Kaioguilherme1/Estacao_Meteorologica_De_baixo_custo_Arduino/README.md

# Estacao_Meteorologica_De_baixo_custo_Arduino
 Trabalho de conclusão do curso Técnico em Agropecuária da Escola Agrotécnica da Universidade Federal de Roraima
