Kaioguilherme1/Estacao_Meteorologica_De_baixo_custo_Arduino/Documentos/Dados Coletados.pdf

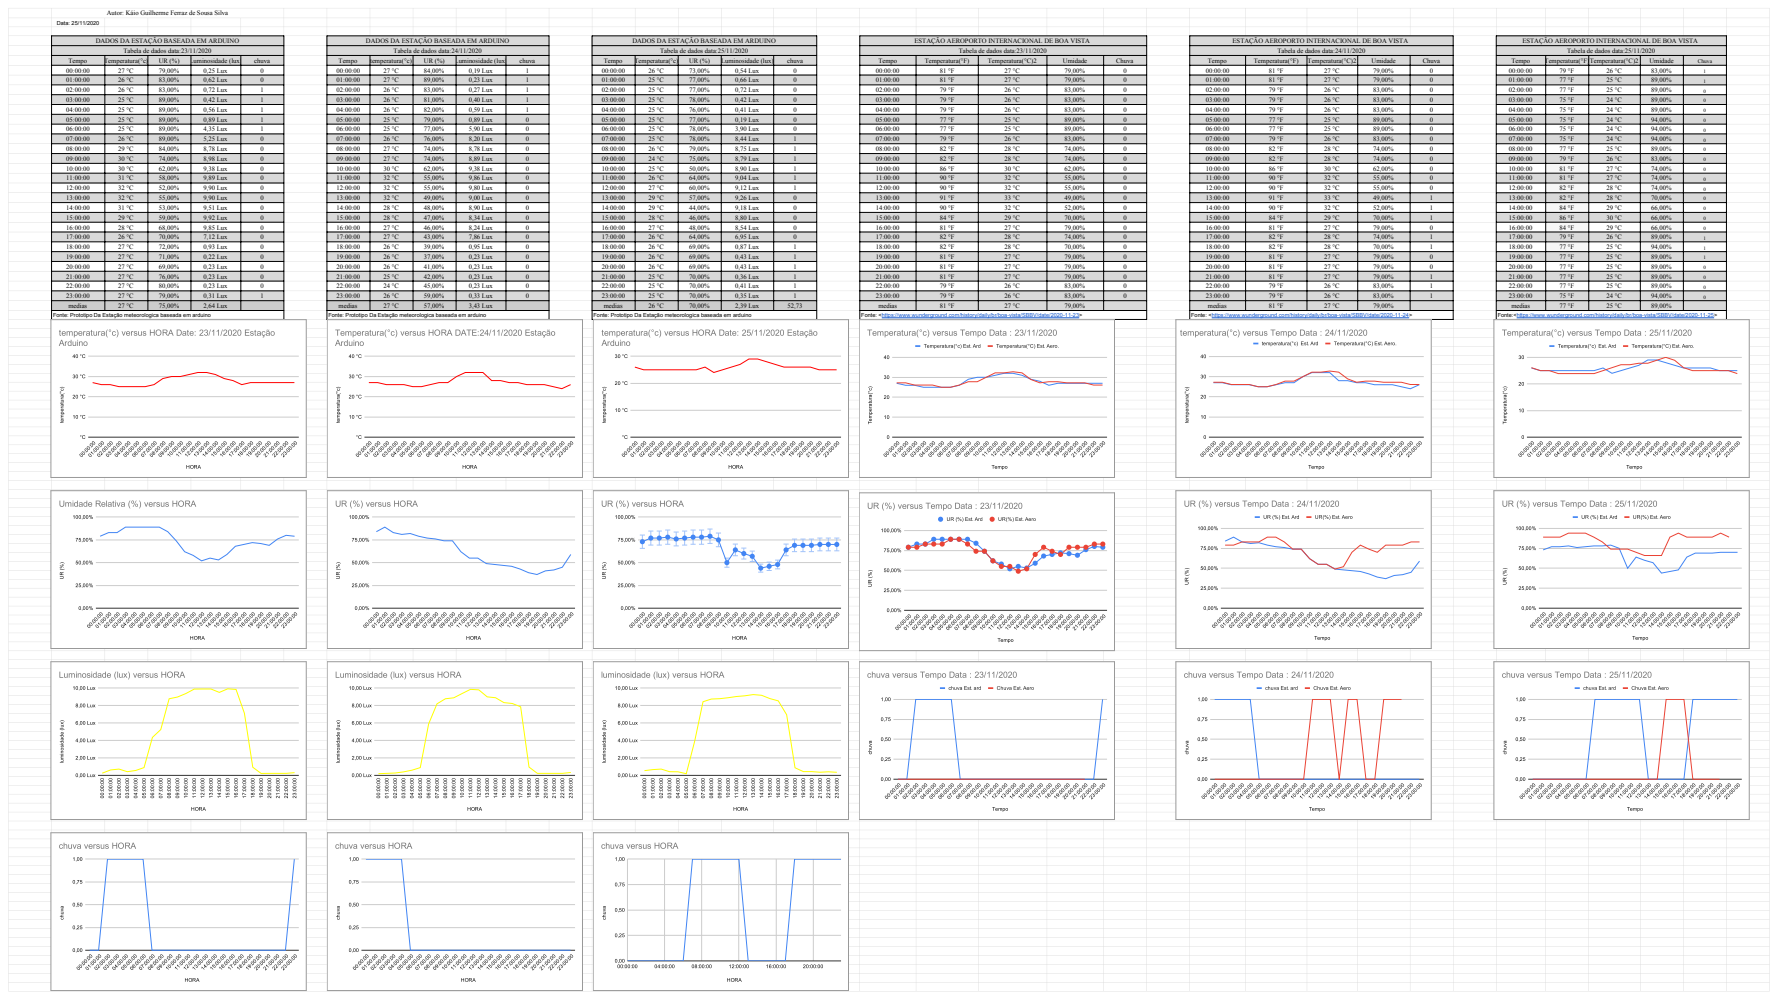
[picture p22: page 1]
Autor: Káio Guilherme Ferraz de Sousa Silva Data: 25/11/2020DADOS DA ESTAÇÂO BASEADA EM ARDUINO; DADOS DA ESTAÇÂO BASEADA EM ARDUINO; ESTAÇÃO AEROPORTO INTERNACIONAL DE BOA VISTA; ESTAÇÃO AEROPORTO INTERNACIONAL DE BOA VISTA Tabela de dados data:23/11/2020; Tabela de dados data:24/11/2020; Tabela de dados data:25/11/2020; Tabela de dados data:23/11/2020; Tabela de dados data:25/11/2020 Tempo; Temperatura(°c); Luminosidade (lux); chuva; Tempo; temperatura(°c); Temperatura(°F); Temperatura(°C)2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
